crazy-m/dcmctrlfw/README

DC Motor Control Firmware

Board based on AT90CAN128 and ATA6824 Brushed DC Motor MOSFET Driver.
