crazy-m/dcmctrlfw/eagle/dcmctrl-mcu-board_v1.brd

## EAGLE design eagle/dcmctrl-mcu-board_v1.brd (2012-07-29)

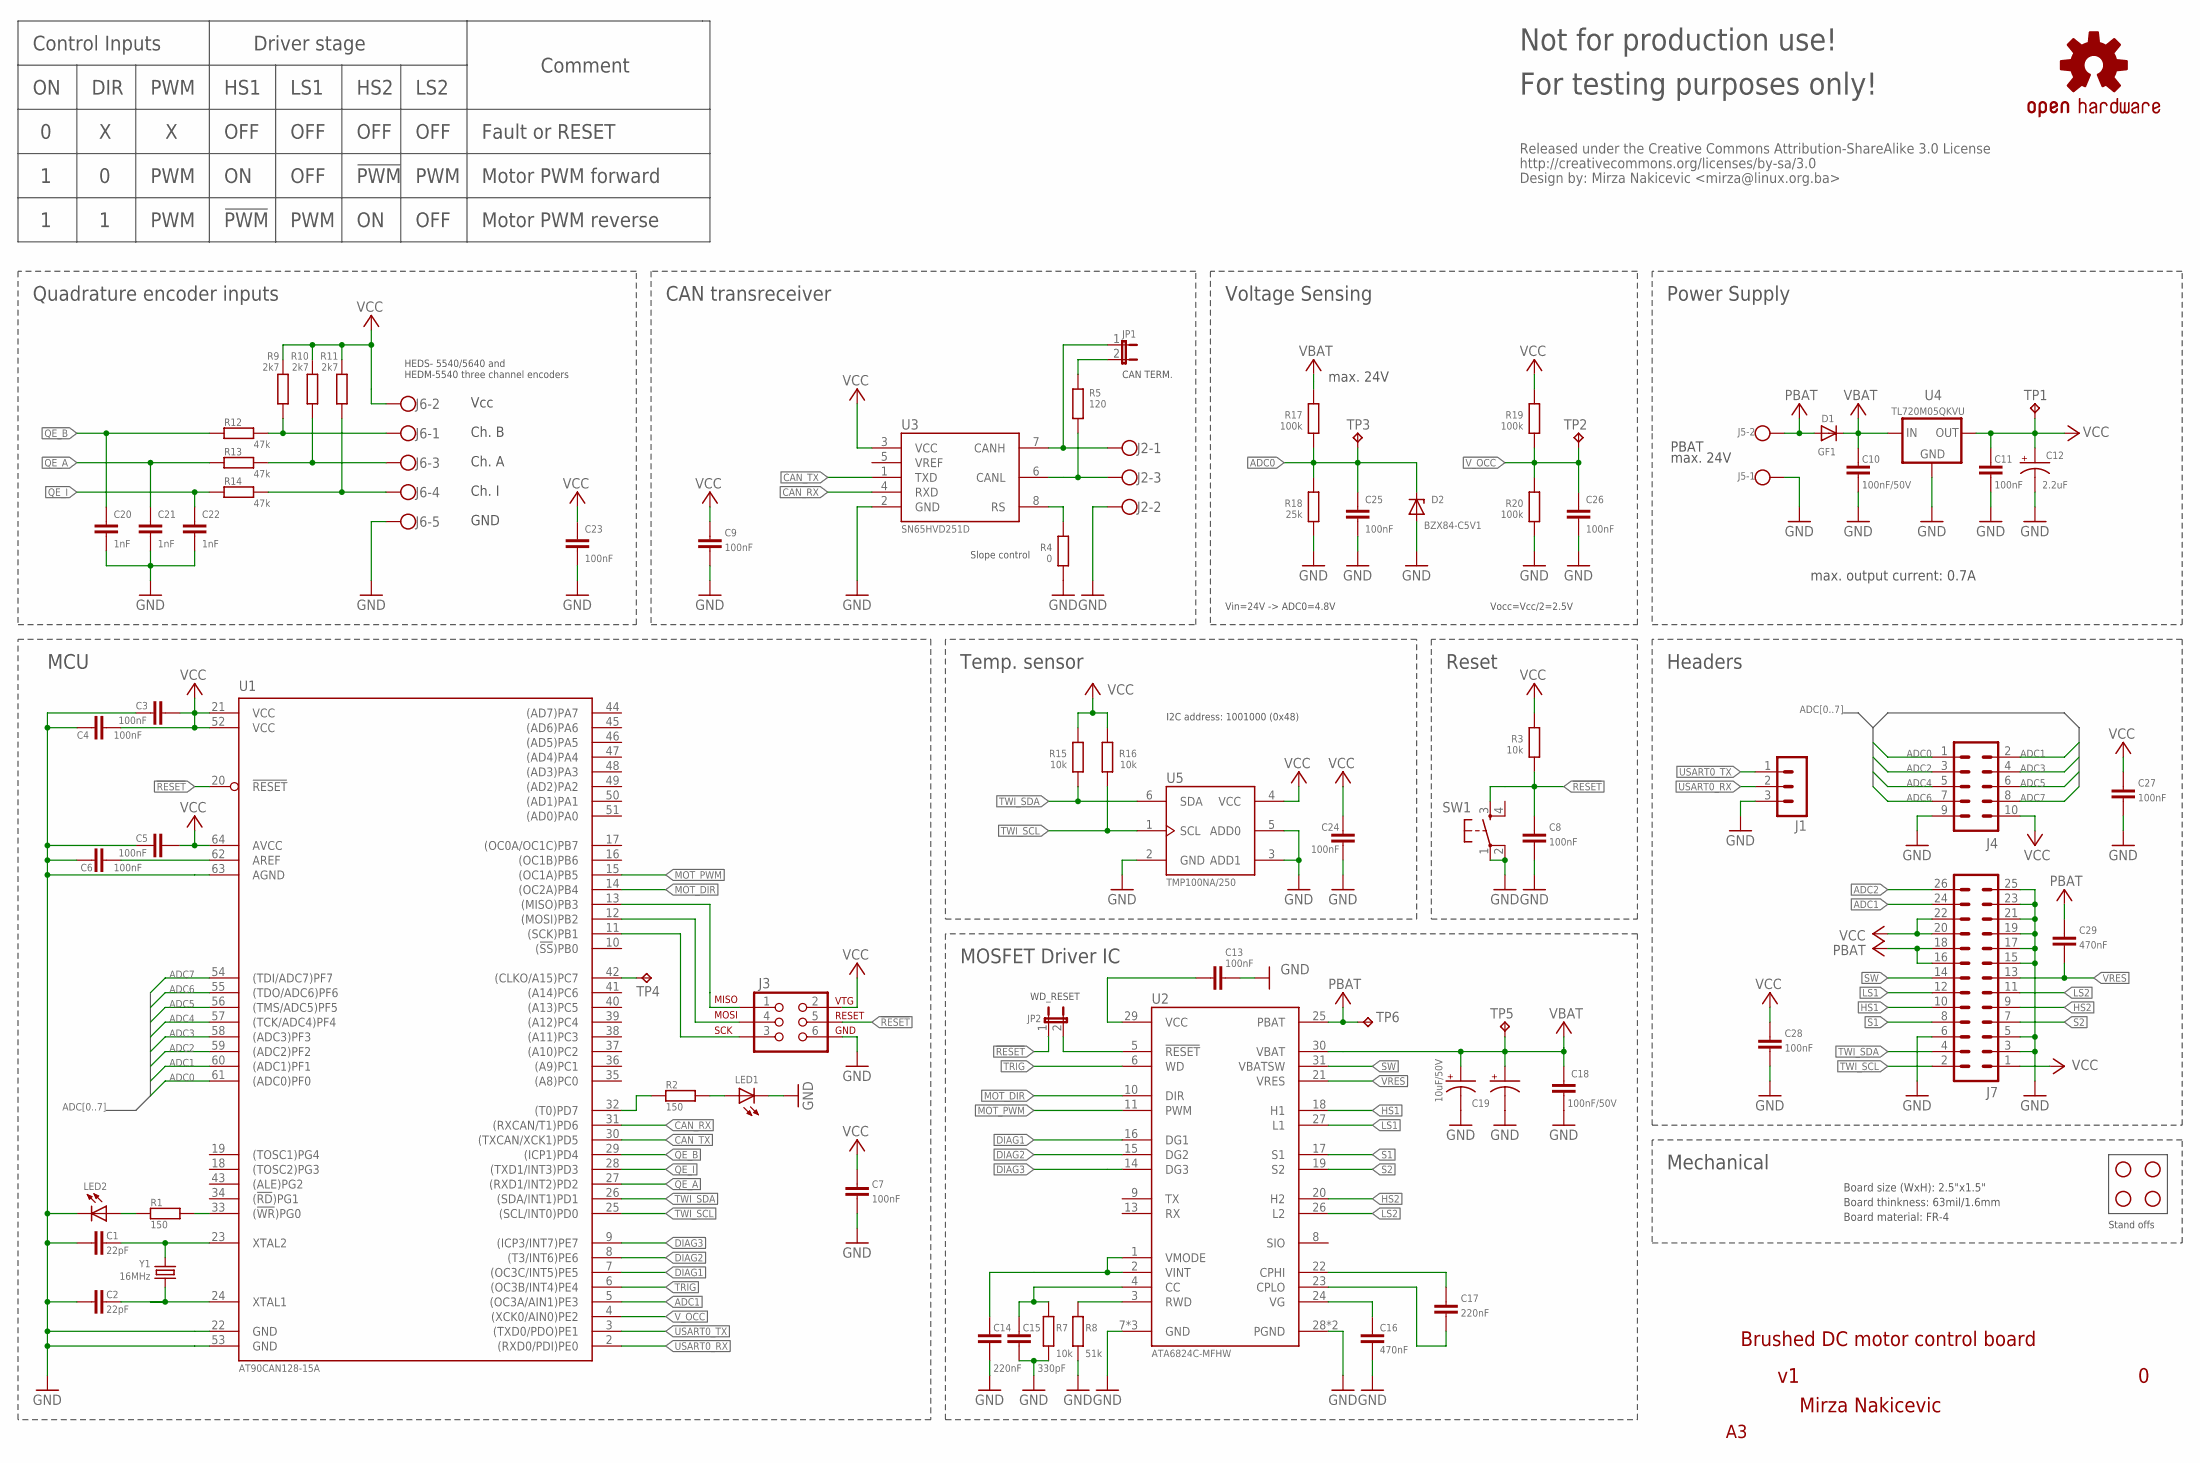
[picture p1: schematic dcmctrl-mcu-board_v1.sch]

Parts:
C1, C2: 22pF; C0603
C3, C4, C5, C6, C7, C8, C9, C11, C13, C23, C24, C25, C26, C27, C28: 100nF; C0603
C10, C18: 100nF/50V; C0603
C12: 2.2uF; EIA3216
C14, C17: 220nF; C0603
C15: 330pF; C0603
C16, C29: 470nF; C0603
C19: 10uF/50V; EIA3528
C20, C21, C22: 1nF; C0603
C999: 10uF/50V; RADIAL-1
D1: GF1; SMA-DO214AC
D2: BZX84-C5V1; TO236
J1: MA03-1
J2: BLOCK3-3.5-4UCON; 4UCON-20193
J3: AVR-ISP-6-100; 2X3-100
J4: MA05-2
J5: BLOCK2-3.5-4UCON; 4UCON-19963
J6: BLOCK5-3.5-4UCON; 4UCON-20223
J7: MA13-2
JP1: JUMPER-2PTH; 1X02
JP2: JUMPER-2SMD-NC; SJ_2S
LED1, LED2: LEDCHIPLED_0603; CHIPLED_0603
R1, R2: 150; R0603
R3, R7, R15, R16: 10k; R0603
R4: 0; R0603
R5: 120; R0805
R8: 51k; R0603
R9, R10, R11: 2k7; R0603
R12, R13, R14: 47k; R0603
R17, R19, R20: 100k; R0603
R18: 25k; R0603
SW1: TAC_SWITCHPTH; TACTILE-PTH
TP1, TP2, TP3, TP4, TP5, TP6: TPB1,27; B1,27
U1: AT90CAN128-15A; TQFP64
U2: ATA6824C-MFHW; TPQFP32
U3: SN65HVD251D; SO-08
U4: TL720M05QKVU; D-PAK_TO252AA
U5: TMP100NA/250; SOT23-6L
U$1, U$2, U$3, U$4: STAND-OFF
U$24: OSHW-LOGOM; OSHW-LOGO-M
U$29: CC-SA
Y1: 16MHz; HC49U-V

Connections:
!RESET: C8.1, J3.5, JP2.1, R3.1, SW1.3, U1.20 (!RESET)
ADC0: C25.1, D2.C, J4.1, R17.1, R18.2, TP3.TP, U1.61 ((ADC0)PF0)
ADC1: J4.2, J7.24, U1.5 ((OC3A/AIN1)PE3), U1.60 ((ADC1)PF1)
ADC2: J4.3, J7.26, U1.59 ((ADC2)PF2)
ADC3: J4.4, U1.58 ((ADC3)PF3)
ADC4: J4.5, U1.57 ((TCK/ADC4)PF4)
ADC5: J4.6, U1.56 ((TMS/ADC5)PF5)
ADC6: J4.7, U1.55 ((TDO/ADC6)PF6)
ADC7: J4.8, U1.54 ((TDI/ADC7)PF7)
CAN_H: J2.1, JP1.1, U3.7 (CANH)
CAN_L: J2.3, R5.2, U3.6 (CANL)
CAN_RX: U1.31 ((RXCAN/T1)PD6), U3.4 (RXD)
CAN_TX: U1.30 ((TXCAN/XCK1)PD5), U3.1 (TXD)
DIAG1: U1.7 ((OC3C/INT5)PE5), U2.16 (DG1)
DIAG2: U1.8 ((T3/INT6)PE6), U2.15 (DG2)
DIAG3: U1.9 ((ICP3/INT7)PE7), U2.14 (DG3)
GND: C1.2, C2.2, C3.2, C4.2, C5.2, C6.2, C7.2, C8.2, C9.2, C10.2, C11.2, C12.C (-), C13.2, C14.2, C15.2, C16.2, C18.2, C19.C (-), C20.2, C21.2, C22.2, C23.2, C24.2, C25.2, C26.2, C27.2, C28.2, C999.2 (-), D2.A, J1.3, J2.2, J3.6, J4.9, J5.1, J6.5, J7.3, J7.5, J7.6, J7.15, J7.17, J7.19, J7.21, J7.23, J7.25, LED1.C, LED2.C, R4.1, R7.1, R8.1, R18.1, R20.1, SW1.1, SW1.2, U1.22 (GND), U1.53 (GND), U1.63 (AGND), U2.7 (GND), U2.12 (GND), U2.28 (PGND), U2.32 (GND), U2.33 (PGND), U3.2 (GND), U4.4 (GND), U5.2 (GND), U5.3 (ADD1), U5.5 (ADD0)
HS1: J7.10, U2.18 (H1)
HS2: J7.9, U2.20 (H2)
LS1: J7.12, U2.27 (L1)
LS2: J7.11, U2.26 (L2)
MOT_DIR: U1.14 ((OC2A)PB4), U2.10 (DIR)
MOT_PWM: U1.15 ((OC1A)PB5), U2.11 (PWM)
unnamed: C1.1, U1.23 (XTAL2), Y1.1
unnamed: C2.1, U1.24 (XTAL1), Y1.2
unnamed: R4.2, U3.8 (RS)
unnamed: JP1.2, R5.1
unnamed: R1.2, U1.33 ((!WR!)PG0)
unnamed: C15.1, R7.2, U2.4 (CC)
unnamed: J3.1, U1.13 ((MISO)PB3)
unnamed: R8.2, U2.3 (RWD)
unnamed: C14.1, U2.1 (VMODE), U2.2 (VINT)
unnamed: C16.1, U2.24 (VG)
unnamed: C17.2, U2.23 (CPLO)
unnamed: C17.1, U2.22 (CPHI)
unnamed: C6.1, U1.62 (AREF)
unnamed: J3.4, U1.12 ((MOSI)PB2)
unnamed: J3.3, U1.11 ((SCK)PB1)
unnamed: TP4.TP, U1.42 ((CLKO/A15)PC7)
unnamed: C13.1, U2.29 (VCC)
unnamed: LED2.A, R1.1
unnamed: R2.2, U1.32 ((T0)PD7)
unnamed: LED1.A, R2.1
PBAT: C29.1, D1.A, J5.2, J7.16, J7.18, TP6.TP, U2.25 (PBAT)
QE_A: C21.1, R13.1, U1.27 ((RXD1/INT2)PD2)
QE_A_IN: J6.3, R10.1, R13.2
QE_B: C20.1, R12.1, U1.29 ((ICP1)PD4)
QE_B_IN: J6.1, R9.1, R12.2
QE_I: C22.1, R14.1, U1.28 ((TXD1/INT3)PD3)
QE_I_IN: J6.4, R11.1, R14.2
S1: J7.8, U2.17 (S1)
S2: J7.7, U2.19 (S2)
SW: J7.14, U2.31 (VBATSW)
TRIG: U1.6 ((OC3B/INT4)PE4), U2.6 (WD)
TWI_SCL: J7.2, R16.1, U1.25 ((SCL/INT0)PD0), U5.1 (SCL)
TWI_SDA: J7.4, R15.1, U1.26 ((SDA/INT1)PD1), U5.6 (SDA)
USART0_RX: J1.2, U1.2 ((RXD0/PDI)PE0)
USART0_TX: J1.1, U1.3 ((TXD0/PDO)PE1)
VBAT: C10.1, C18.1, C19.A (+), C999.1 (+), D1.K (C), R17.2, TP5.TP, U2.30 (VBAT), U4.1 (IN)
VCC: C3.1, C4.1, C5.1, C7.1, C9.1, C11.1, C12.A (+), C23.1, C24.1, C27.1, C28.1, J3.2, J4.10, J6.2, J7.1, J7.20, J7.22, R3.2, R9.2, R10.2, R11.2, R15.2, R16.2, R19.2, TP1.TP, U1.21 (VCC), U1.52 (VCC), U1.64 (AVCC), U3.3 (VCC), U4.3 (OUT), U5.4 (VCC)
VRES: C29.2, J7.13, U2.21 (VRES)
V_OCC: C26.1, R19.1, R20.2, TP2.TP, U1.4 ((XCK0/AIN0)PE2)
WD_RESET: JP2.2, U2.5 (!RESET)

Notes on the sheet:
MCU
Reset
Power Supply
Voltage Sensing
Quadrature encoder inputs
Headers
MOSFET Driver IC
CAN transreceiver
Temp. sensor
Brushed DC motor control board
Mirza Nakicevic
WD_RESET
CAN TERM.
Control Inputs
DIR
PWM
Driver stage
HS1
LS1
HS2
LS2
OFF
!PWM
Comment
Fault or RESET
Motor PWM forward
Motor PWM reverse
Slope control
Mechanical
Board size (WxH): 2.5"x1.5"
Board material: FR-4
Board thinkness: 63mil/1.6mm
Not for production use!
For testing purposes only!
max. 24V
Vin=24V -> ADC0=4.8V
Vocc=Vcc/2=2.5V
Vcc
Ch. B
Ch. A
Ch. I
GND
HEDS- 5540/5640 and
HEDM-5540 three channel encoders
PBAT
max. output current: 0.7A
I2C address: 1001000 (0x48)
Stand offs

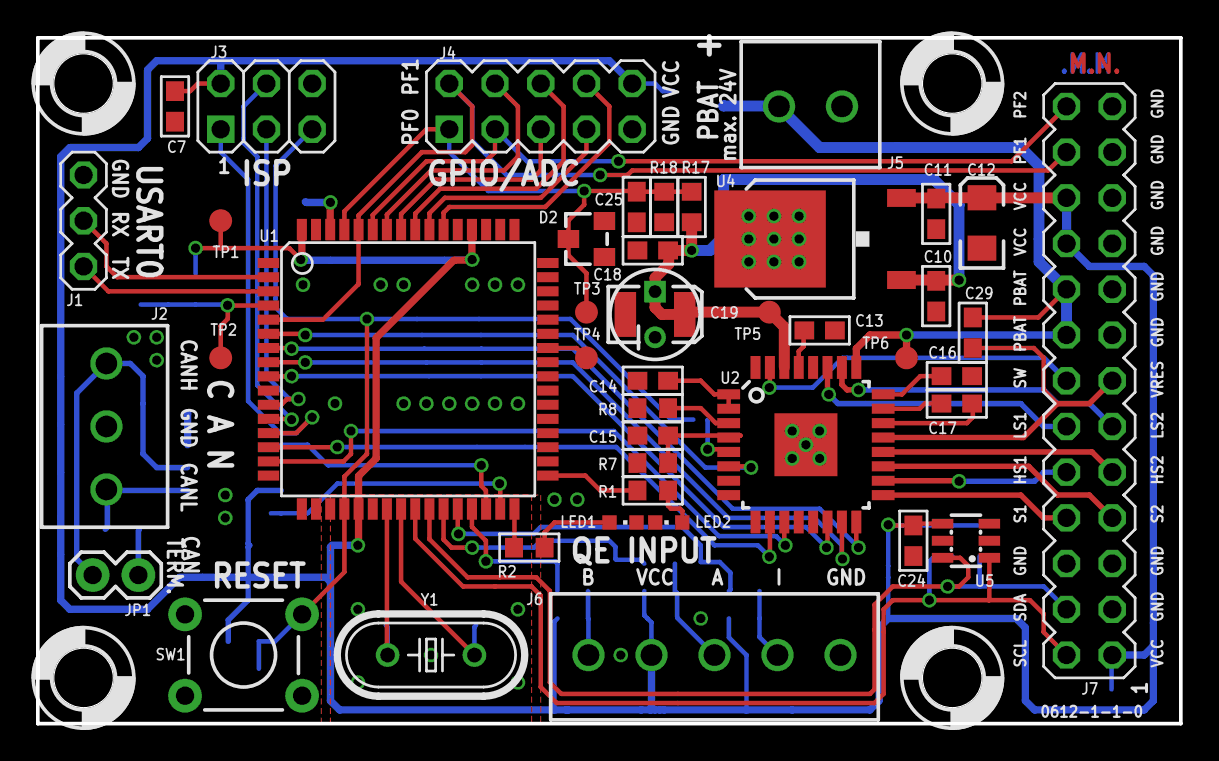
[picture p2: board dcmctrl-mcu-board_v1.brd from above]

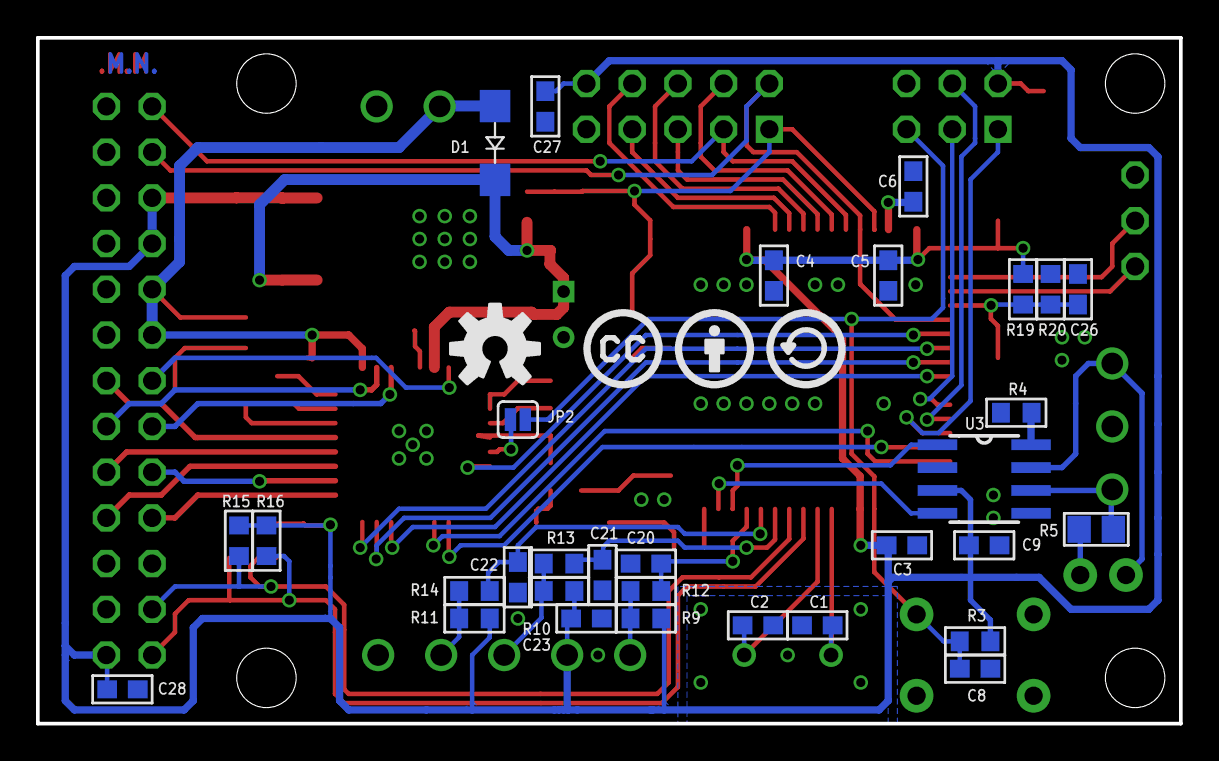
[picture p3: board dcmctrl-mcu-board_v1.brd from below]

Board: 2 copper layers, 63.5 x 38.1 mm, 81 parts (33 on the bottom side), 63 nets.
