crazy-m/dcmctrlfw/eagle/dcmctrl-hb-1-board_v1.brd

## EAGLE design eagle/dcmctrl-hb-1-board_v1.brd (2012-07-29)

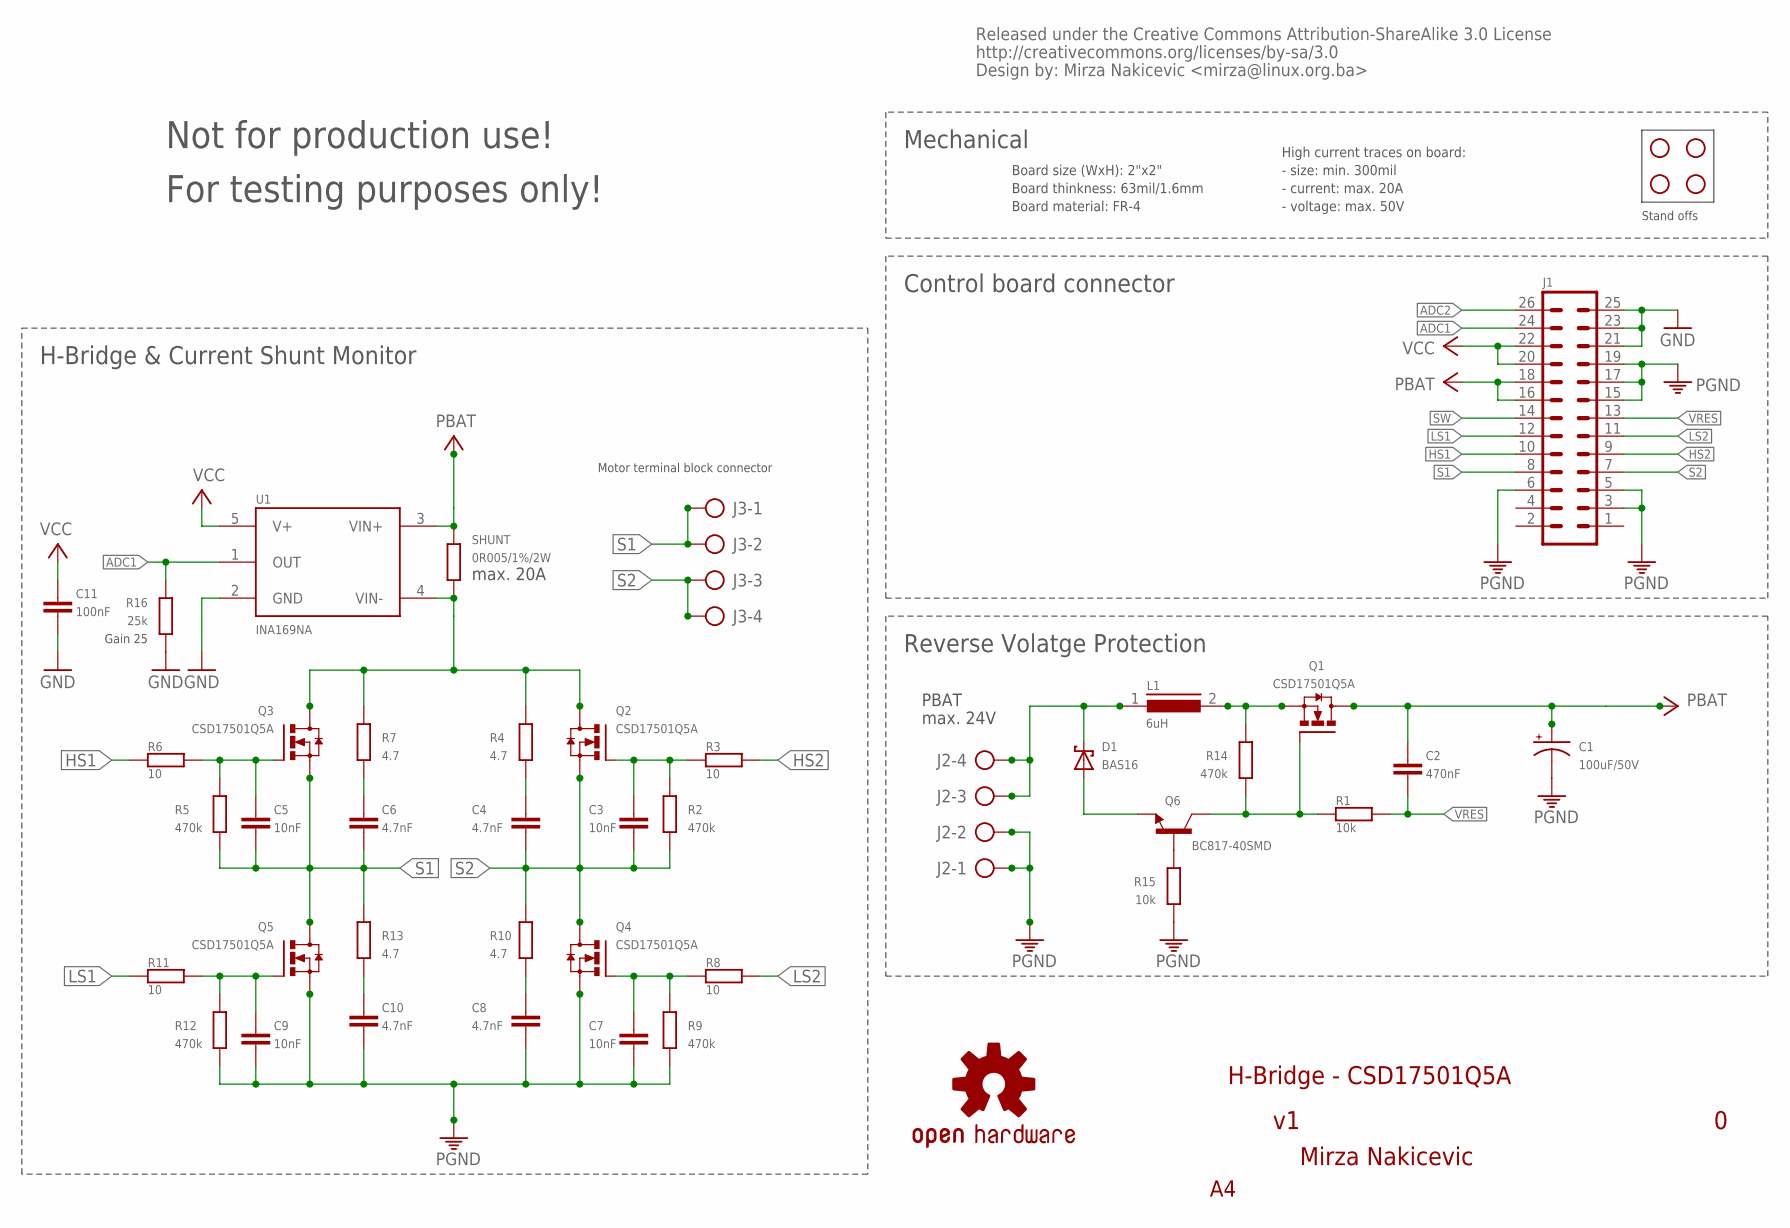
[picture p4: schematic dcmctrl-hb-1-board_v1.sch]

Parts:
C1: 100uF/50V; E5-13
C2: 470nF; C0603
C3, C5, C7, C9: 10nF; C0603
C4, C6, C8, C10: 4.7nF; C0603
C11: 100nF; C0603
D1: BAS16; SOT23
J1: MA13-2
J2, J3: W237-4
L1: 6uH; DR127
Q1, Q2, Q3, Q4, Q5: CSD17501Q5A; Q5A
Q6: BC817-40SMD; SOT23-BEC
R1, R15: 10k; R0603
R2, R5, R9, R12, R14: 470k; R0603
R3, R6, R8, R11: 10; R0603
R4, R7, R10, R13: 4.7; R0603
R16: 25k; R0603
SHUNT: 0R005/1%/2W; R2512
U1: INA169NA; SOT23-5
U$2, U$3, U$4, U$6: STAND-OFF
U$9: CC-SA
U$10: OSHW-LOGOM; OSHW-LOGO-M

Connections:
ADC1: J1.24, R16.2, U1.1 (OUT)
ADC2: J1.26
GND: C11.2, J1.21, J1.23, J1.25, R16.1, U1.2 (GND)
HS1: J1.10, R6.1
HS2: J1.9, R3.2
LS1: J1.12, R11.1
LS2: J1.11, R8.2
unnamed: C5.1, Q3.4 (G), R5.2, R6.2
unnamed: Q6.B, R15.2
unnamed: C9.1, Q5.4 (G), R11.2, R12.2
unnamed: C7.1, Q4.4 (G), R8.1, R9.2
unnamed: C3.1, Q2.4 (G), R2.2, R3.1
unnamed: C6.1, R7.1
unnamed: D1.1 (A), Q6.E
unnamed: C10.1, R13.1
unnamed: Q1.4 (G), Q6.C, R1.1, R14.1
unnamed: C8.1, R10.1
unnamed: C4.1, R4.1
PBAT: C1.+, C2.1, J1.16, J1.18, Q1.5 (D), Q1.6 (D), Q1.7 (D), Q1.8 (D), Q1.TP (D), SHUNT.2, U1.3 (VIN+)
PBAT-: Q2.5 (D), Q2.6 (D), Q2.7 (D), Q2.8 (D), Q2.TP (D), Q3.5 (D), Q3.6 (D), Q3.7 (D), Q3.8 (D), Q3.TP (D), R4.2, R7.2, SHUNT.1, U1.4 (VIN-)
PGND: C1.-, C7.2, C8.2, C9.2, C10.2, J1.3, J1.5, J1.6, J1.15, J1.17, J1.19, J2.1, J2.2, Q4.1 (S), Q4.2 (S), Q4.3 (S), Q5.1 (S), Q5.2 (S), Q5.3 (S), R9.1, R12.1, R15.1
S1: C5.2, C6.2, J1.8, J3.1, J3.2, Q3.1 (S), Q3.2 (S), Q3.3 (S), Q5.5 (D), Q5.6 (D), Q5.7 (D), Q5.8 (D), Q5.TP (D), R5.1, R13.2
S2: C3.2, C4.2, J1.7, J3.3, J3.4, Q2.1 (S), Q2.2 (S), Q2.3 (S), Q4.5 (D), Q4.6 (D), Q4.7 (D), Q4.8 (D), Q4.TP (D), R2.1, R10.2
SW: J1.14
VCC: C11.1, J1.20, J1.22, U1.5 (V+)
VIN: D1.3 (C), J2.3, J2.4, L1.1
VIN2: L1.2, Q1.1 (S), Q1.2 (S), Q1.3 (S), R14.2
VRES: C2.2, J1.13, R1.2

Notes on the sheet:
H-Bridge & Current Shunt Monitor
Not for production use!
For testing purposes only!
Control board connector
Reverse Volatge Protection
max. 24V
PBAT
max. 20A
Gain 25
Mechanical
Board size (WxH): 2"x2"
Board material: FR-4
Board thinkness: 63mil/1.6mm
- size: min. 300mil
- current: max. 20A
- voltage: max. 50V
High current traces on board:
Motor terminal block connector
H-Bridge - CSD17501Q5A
Mirza Nakicevic
Stand offs

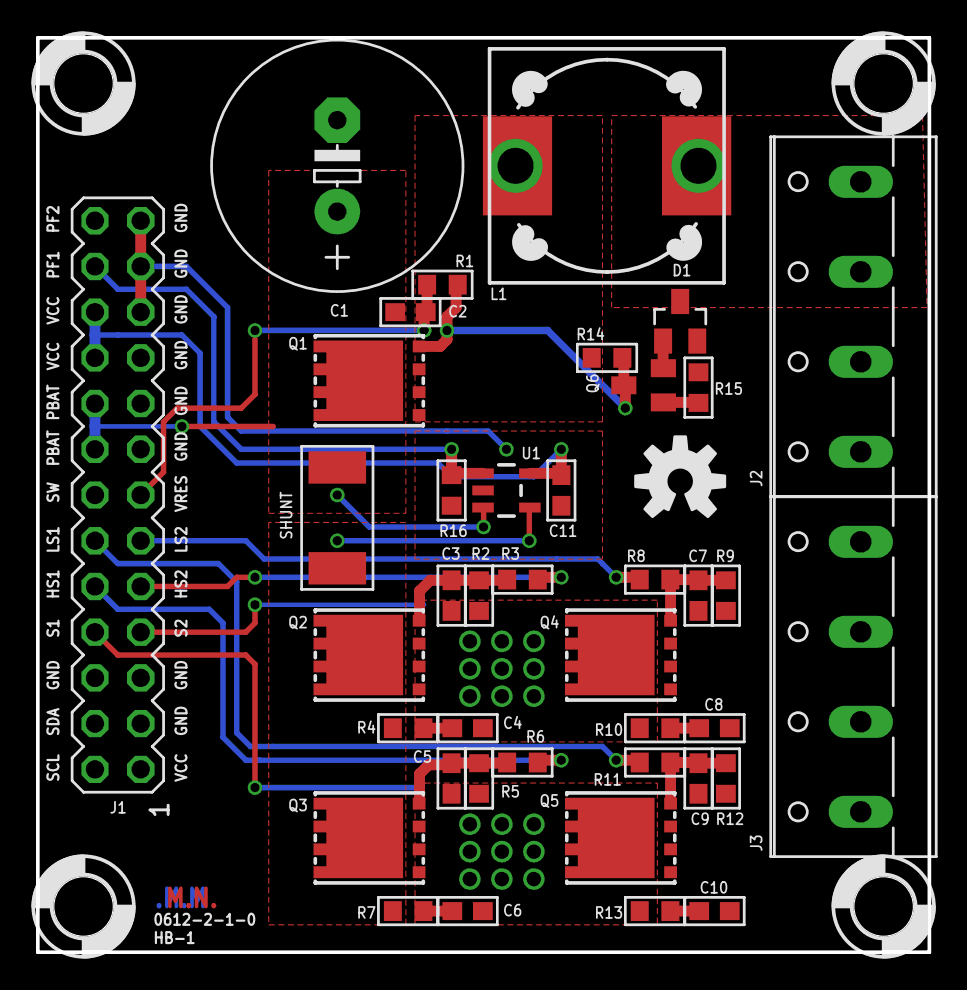
[picture p5: board dcmctrl-hb-1-board_v1.brd from above]

Board: 2 copper layers, 49.5 x 50.8 mm, 46 parts (1 on the bottom side), 26 nets.
