crazy-m/dcmctrlfw/(notices)

Notices in the files:
can.c:
dcmctrlfw is free software: you can redistribute it and/or modify
it under the terms of the GNU General Public License as published by
the Free Software Foundation, either version 3 of the License, or
(at your option) any later version.
parts and their libraries:
other: Released under the Creative Commons Attribution-ShareAlike 3.0 License
other: http://creativecommons.org/licenses/by-sa/3.0
